flyonspeed/OnSpeed-Gen1/docs/AOA_Due_schem.png

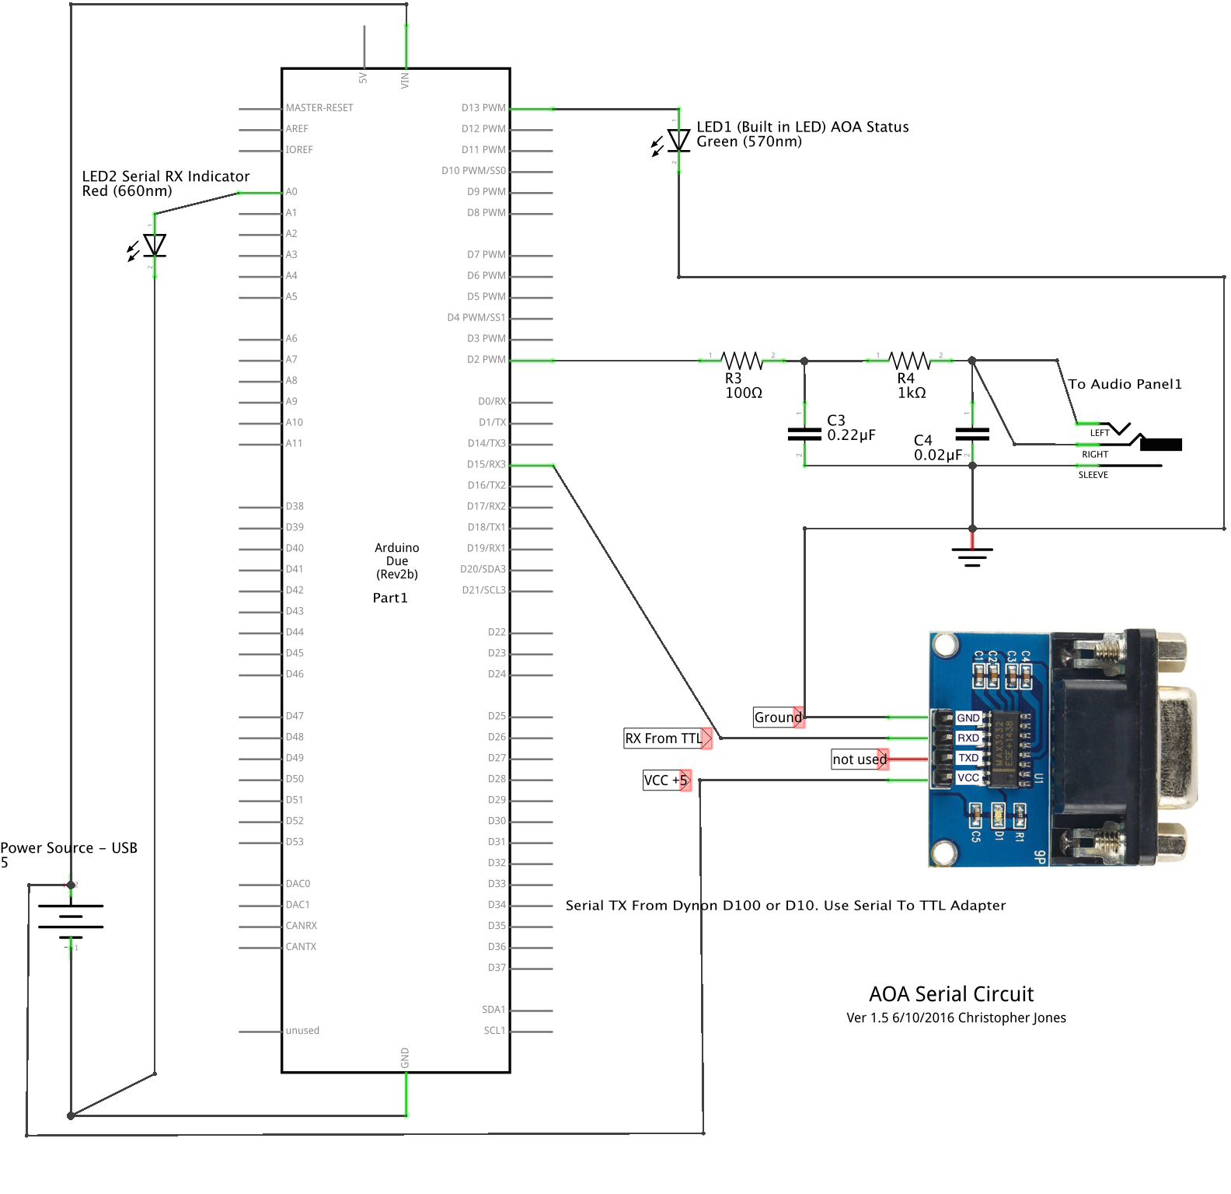
docs/AOA_Due_schem.png
