flyonspeed/OnSpeed-Gen1/docs/AOA_Due_schem_5Jun18.png

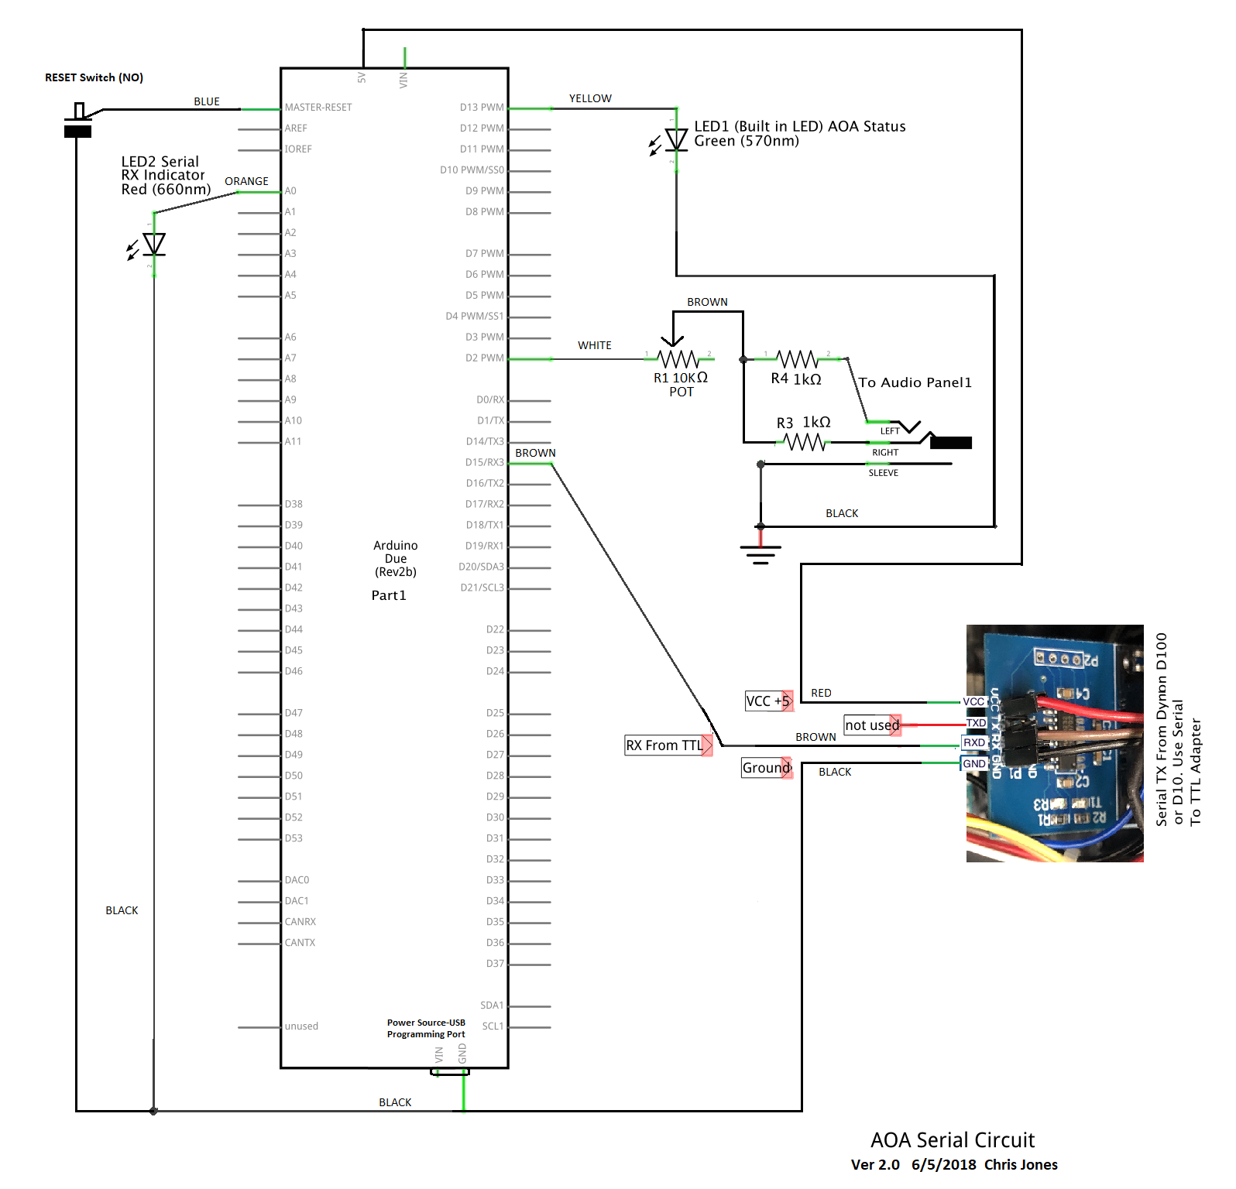
docs/AOA_Due_schem_5Jun18.png
