flyonspeed/OnSpeed-Gen1/docs/chart.png

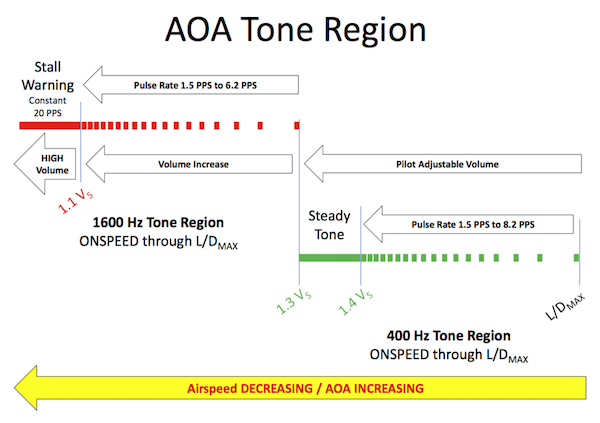
docs/chart.png
