flyonspeed/OnSpeed-Gen1/(commit log)

2016-06-12 Fixes
    Fixed muted auto under airspeed issue. And updated default low airspeed.
    [AOA_TONE_EFIS_SERIAL.ino]
2016-06-14 More defines, added skyview, led on startup
    skyview support has not been tested yet.
2018-07-09 fix for tone PPS between solid tones. was not calucating the right ratio for the PPS changes.
    [AOA_TONE_EFIS_SERIAL.ino]
2018-09-02 Atempts to fix hang up issues with skyview data. Changed start up tones. added more comments. fix min PPS for low tone.
    [AOA_TONE_EFIS_SERIAL.ino]
2018-09-28 skyview lockup issue fixed.
    [AOA_TONE_EFIS_SERIAL.ino]
